cinderblock/DiscoDanceFloor/Floor Node Hardware/BOM.xlsx

#ITEM | Description | Designator | PACKAGE | Manufacturer | Manufacturer Part Number# | Supplier | Supplier Part # | QTY/BOARD | Order QTY
1 | CAP CER 100pF 0805 25V+ | C1,C14 | CAPC2012X145N |  |  | Gold Phoenix |  | 2
2 | CAP CER 18pF 0805 25V+ | C10,C11 | CAPC2012X145N |  |  | Gold Phoenix |  | 2
3 | CAP CER .33uF 0805 25V+ | C13 | CAPC2012X145N |  |  | Gold Phoenix |  | 1
4 | CAP CER .1uF 0805 25V+ | C2,C6,C7,C8 | CAPC2012X145N |  |  | Gold Phoenix |  | 4
5 | CAP CER 1nF 0805 50V+ | C3 | CAPC2012X145N |  |  | Gold Phoenix |  | 1
6 | CAP CER 1uF 0805 25V+ | C9 | CAPC2012X145N |  |  | Gold Phoenix |  | 1
7 | CAP CER 22uF 1206/1210 25V+ | C5,C12 | CAPC3225X279N |  |  | Gold Phoenix |  | 2
8 | RES SMD 20K OHM 5% 0805 | R1,R11,R12,R13,R14,R16 | RESC2012X70N |  |  | Gold Phoenix |  | 6
9 | RES SMD 40K OHM 5% 0805 | R10 | RESC2012X70N |  |  | Gold Phoenix |  | 1
10 | RES SMD 10M OHM 5% 0805 | R2 | RESC2012X70N |  |  | Gold Phoenix |  | 1
11 | RES SMD 82.5 OHM 5% 0805 | R3,R5 | RESC2012X70N |  |  | Gold Phoenix |  | 2
12 | RES SMD 145 OHM 5% 0805 | R4,R6 | RESC2012X70N |  |  | Gold Phoenix |  | 2
13 | RES SMD 1 OHM 5% 0805 | R7,R8,R9 | RESC2012X70N |  |  | Gold Phoenix |  | 3
14 | MOSFET N-CH 30V 500MA SOT-23 | Q1,Q2,Q3 | SOT95P237X111-3N | ON Semiconductor | NTR4003NT1G | Digi-Key | NTR4003NT1GOSCT-ND | 3
15 | IC MCU 8BIT 16KB FLASH 32TQFP | U1 | QFP80P900X900X120-32N | Atmel | ATMEGA168PB-AUR | Digi-Key | ATMEGA168PB-AURCT-ND | 1
16 | IC REG LDO 5V 0.5A DPAK | U2 | TO228P991X238-3N | STMicroelectronics | L78M05CDT-TR | Digi-Key | 497-1203-1-ND | 1
17 | TXRX ESD RS-485/422 LP 8-SOIC | U3 | SOIC127P600X175-8N | Intersil | ISL81487EIBZ-T | Digi-Key | ISL81487EIBZ-TCT-ND | 1
18 | LED RGB 615/525/470NM DIFF 0606 | LED | 0606 | Lite-On Inc | LTST-C19HE1WT | Digi-Key | 160-2162-1-ND | 1
19 | Crystal 20.0000MHz 20ppm 18pF … | Y1 | HC49/US | Abracon LLC | ABLS7M2-20.000MHZ-D-2Y-T | Digi-Key | 535-12832-1-ND | 1
20 | CONN HEADER 2POS .156 R/A TIN | J1 | Through Hole | Molex Inc | 26605020 | Digi-Key | WM4640-ND | 1
21 | Connector Quick Connect Tab 0.250" (6.35mm) | CS | Through Hole | TE Connectivity AMP Connectors | 1217861-1 | Digi-Key | A100452CT-ND | 1
22 | CONN HDR .100" SNGL PCB RA 4POS | LEDS | Through Hole | Sullins Connector Solutions | SWR25X-NRTC-S04-RB-BA | Digi-Key | S9490-ND | 1
23 | CONN MOD JACK 8P8C R/A UNSHLD | NEXT,PREV | Through Hole | FCI | 54602-908LF | Digi-Key | 609-1046-ND | 2
24 | HDR1X6 | FTDI |  | DO NOT INSERT | DO NOT INSERT | DO NOT INSERT | DO NOT INSERT
25 | Programming Pads | ISP1,ISP2 |  | DO NOT INSERT | DO NOT INSERT | DO NOT INSERT | DO NOT INSERT
26 | HDR2X3 | ISP3 |  | DO NOT INSERT | DO NOT INSERT | DO NOT INSERT | DO NOT INSERT
27 | HDR1X3 | J2 |  | DO NOT INSERT | DO NOT INSERT | DO NOT INSERT | DO NOT INSERT
28 | RES SMD 120 OHM 5% 0805 | R15 | RESC2012X70N | DO NOT INSERT | DO NOT INSERT | DO NOT INSERT | DO NOT INSERT
29 | CAP CER 1uF 0805 25V+ | C4 | CAPC2012X145N | DO NOT INSERT | DO NOT INSERT | DO NOT INSERT | DO NOT INSERT
