cinderblock/DiscoDanceFloor/Floor Node Hardware/Schematic.pdf

U1

## Atmega328p

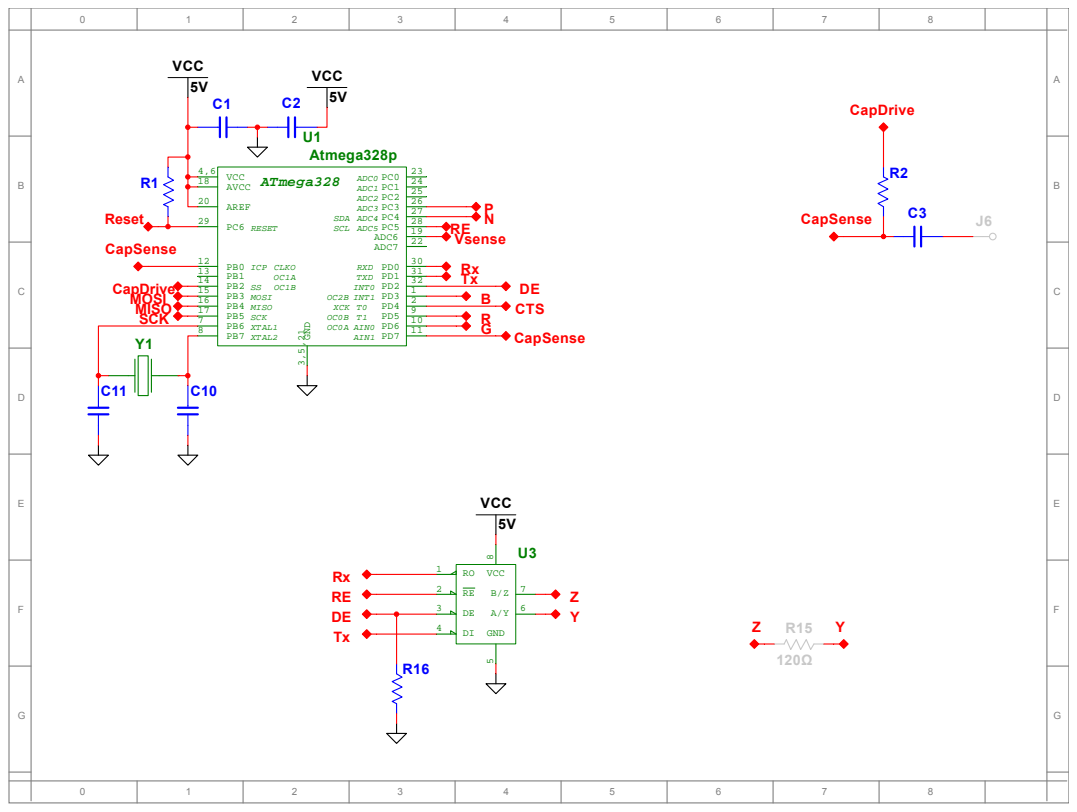
[picture p1: page 1]

## ISP1 MISO MOSI SCK

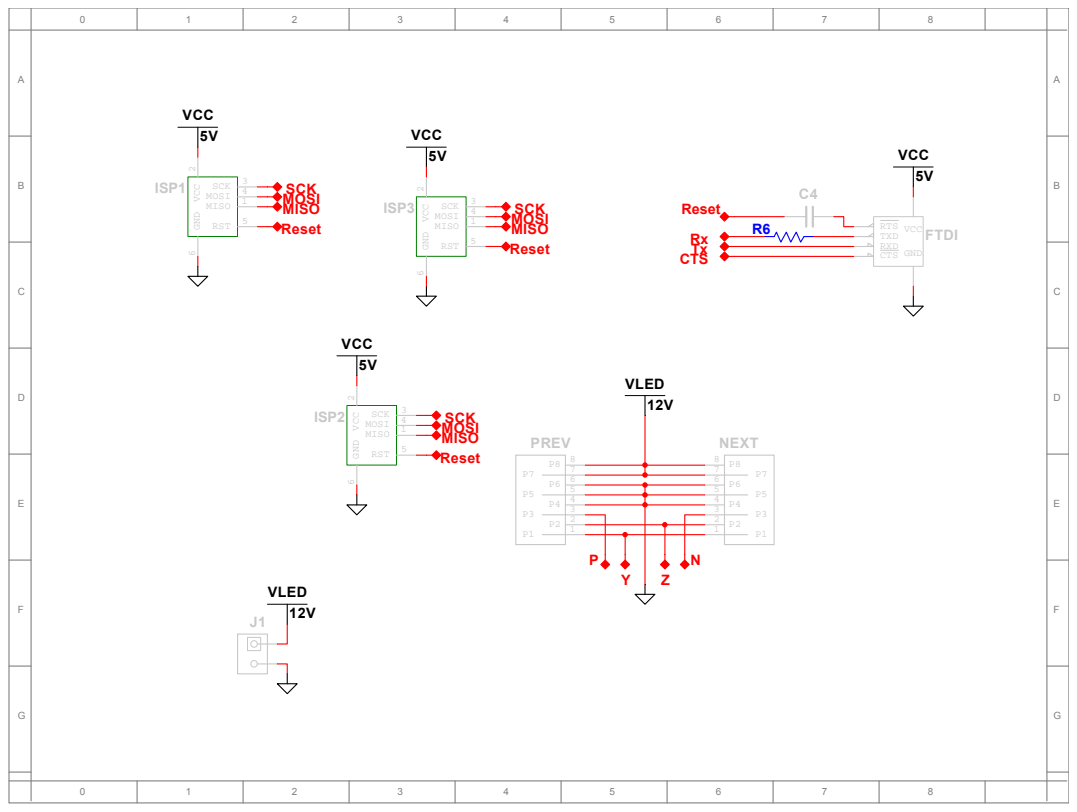
[picture p2: page 2]

## VCC

## LEDS

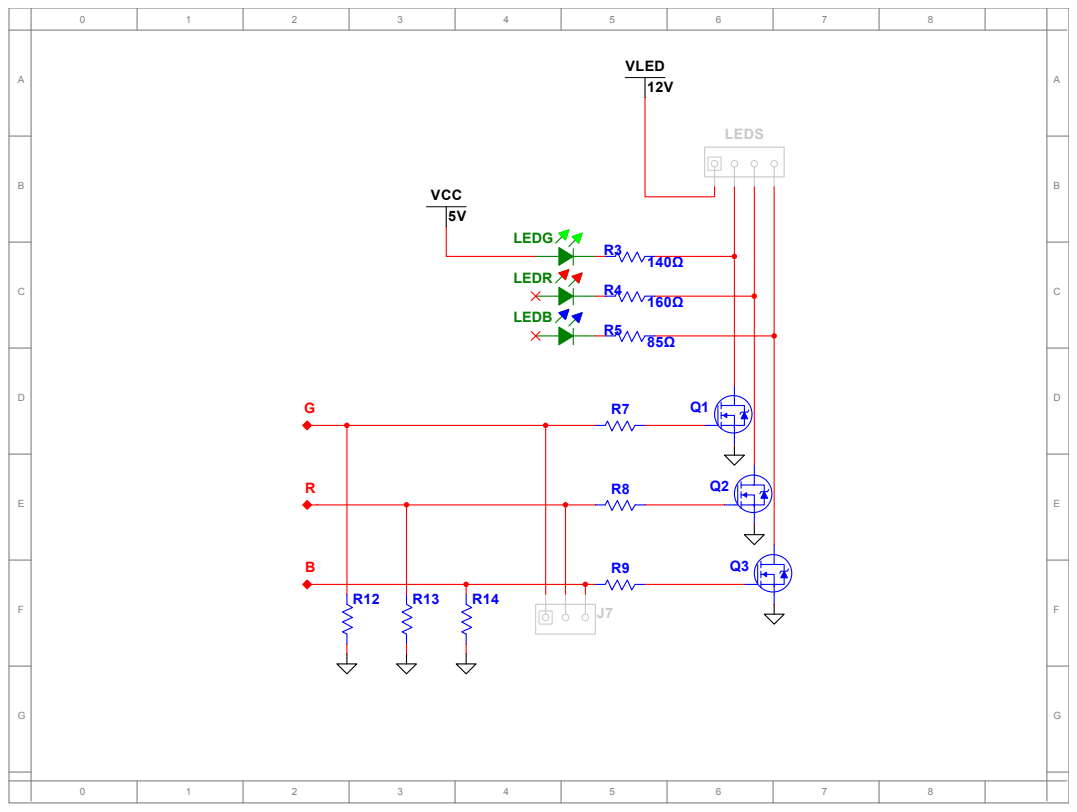
[picture p3: page 3]

## VLED

12V

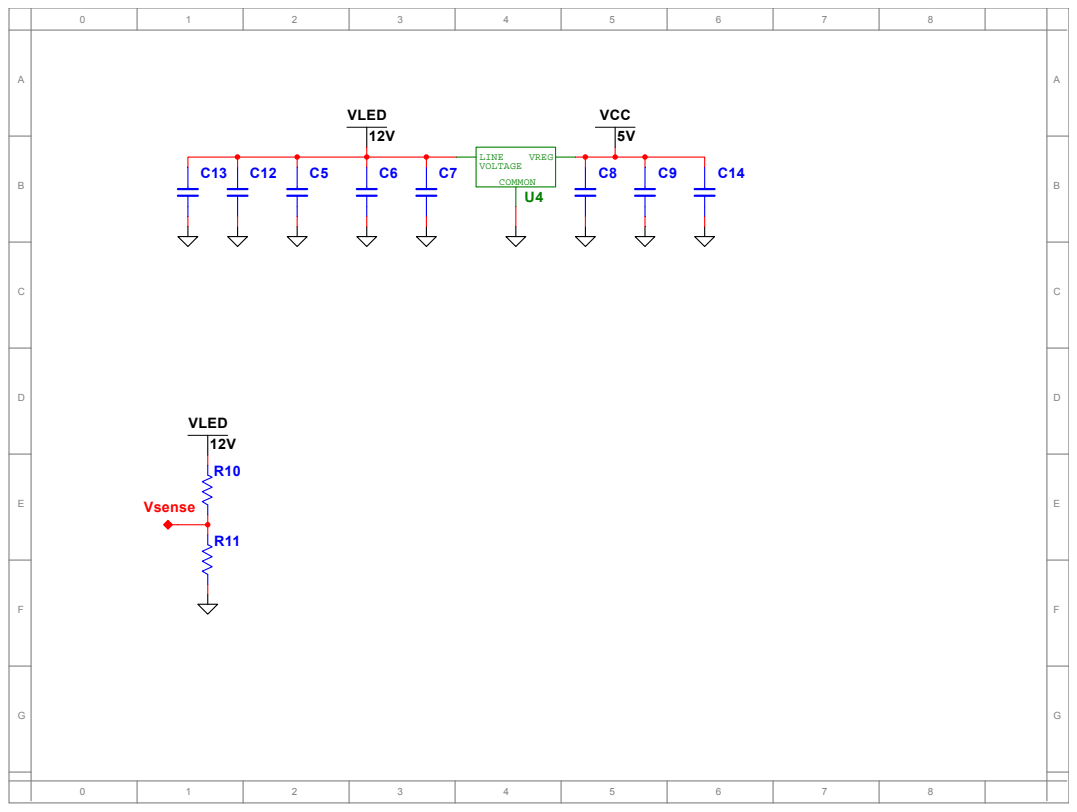
[picture p4: page 4]
