cinderblock/DiscoDanceFloor/(list of files, drawings)

Other design files:
Floor Node Hardware/Floor Node.ms13
