cinderblock/DiscoDanceFloor/FloorNode/Constants.h

// Commands codes
#define TYPE_ACK          0x01 // Acknowledge command
#define TYPE_ADDR         0x02 // Announce address
#define TYPE_COLOR        0x04 // Set color
#define TYPE_FADE         0x05 // Set fade
#define TYPE_STATUS       0x06 // Set or Get node status
#define TYPE_RESET        0x10 // Reset node

// Flags
#define FADING           B001
#define SENSOR_DETECT    B010

// PINS
#define TX_CONTROL       2    // RS485 TX Enable
#define SENSOR_SEND      3    // Connect a resistor from this pin to SENSOR_OUT
#define SENSOR_TOUCH     4    // Connected to sensor area
#define NEXT_NODE        5    // Enables the next node so it can register itself
#define ENABLE_NODE      6    // Sets ID when HIGH
#define ENABLE_MASTER    7
#define NODE_STATUS      8

// RGB LED Pins
#define LED_RED          11
#define LED_GREEN        9
#define LED_BLUE         10

// RX/TX enable
#define RS485Transmit    HIGH
#define RS485Receive     LOW

// EEPROM Addresses
#define EEPROM_CELL_ADDR 0

// Everything else
#define SENSOR_THRESHOLD    100  // The value the capactive sensor must cross to register as ON
#define ACK_TIMEOUT         10   // How many milliseconds to wait for an ACK
#define FADE_DIVIDER        250  // What to divide the duration by before sending
