cinderblock/DiscoDanceFloor/FloorNode/FloorNode.h

void updateLEDs();
void processMessage();
void setAddress();
void masterMessage();
void myMessage();
void addressConfirmed();
void handleColorMessage();
void handleFadeMessage();
void sendStatus();
bool sensorValue();
void sendStatus();
bool isFading();
void setColor(uint8_t red, uint8_t green, uint8_t blue);
void fadeToColor(int time, uint8_t red, uint8_t green, uint8_t blue);
