cinderblock/DiscoDanceFloor/(commit log)

2015-04-13 Bringing DanceFloorNode out of the Arduino IDE
2015-05-06 Initial schematic for Floor Node hardware.
    ATmega328
    IQS211
    Programming headers
    Clock input / debug
    Cap Drive on OC1B
    [Floor Node.ms13]
2015-05-07 Adding RS485 transceiver
    [Floor Node.ms13]
2015-05-21 Adding connectors and finishing all of the board features
    [Floor Node.ms13]
2015-05-24 Laying out connectors on the PCB edge
    [Floor Node.ms13]
2015-05-25 AVR and LEDS wired up.
    [Floor Node.ms13]
2015-05-25 Adding PDF version of ms13 schematic
2015-05-25 Final board layout. Nearly all IO routed
    [Floor Node.ms13]
2015-05-25 Shrank things a little. Real final size.
    [Floor Node.ms13]
2015-05-26 All nets connected!
    [Floor Node.ms13]
2015-05-28 Updated passives' values and starting variant management
    [Floor Node.ms13]
2015-06-27 Removing ISQ and new headers
    [Floor Node.ms13]
2015-06-28 All components generally placed
    [Floor Node.ms13]
2015-06-28 New schematic
2015-06-28 Adding missing pull downs
    [Floor Node.ms13]
2015-06-29 Basically final design. Needs a little cleanup
    [Floor Node.ms13]
2015-06-30 Adding a couple extra final capacitors and final cleanup. Nearly ready to hit order.
    [Floor Node.ms13]
2015-06-30 Cleanup a few more little things. Adding a lot of text.
    [Floor Node.ms13]
2015-07-08 Exporting for manufacturing and assembly.
    Fixed capacitor values. Fixed a REFDES or two
    [Floor Node.ms13]
2015-07-08 DERP! Forgot to fix the solder mask layer on some late vias
2015-07-10 Version for final production
    [BOM.xlsx, Floor Node.ms13]
